Senyeah/12v-to-usb-c-data-splitter/docs/swift-usbc-3a-iso-back.png

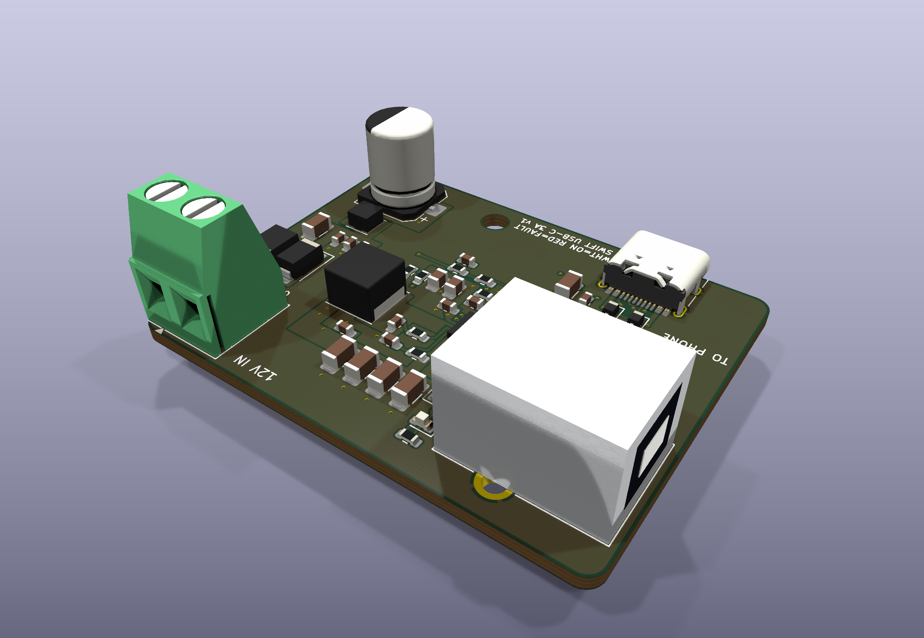
docs/swift-usbc-3a-iso-back.png
