Senyeah/12v-to-usb-c-data-splitter/docs/swift-usbc-3a-iso.png

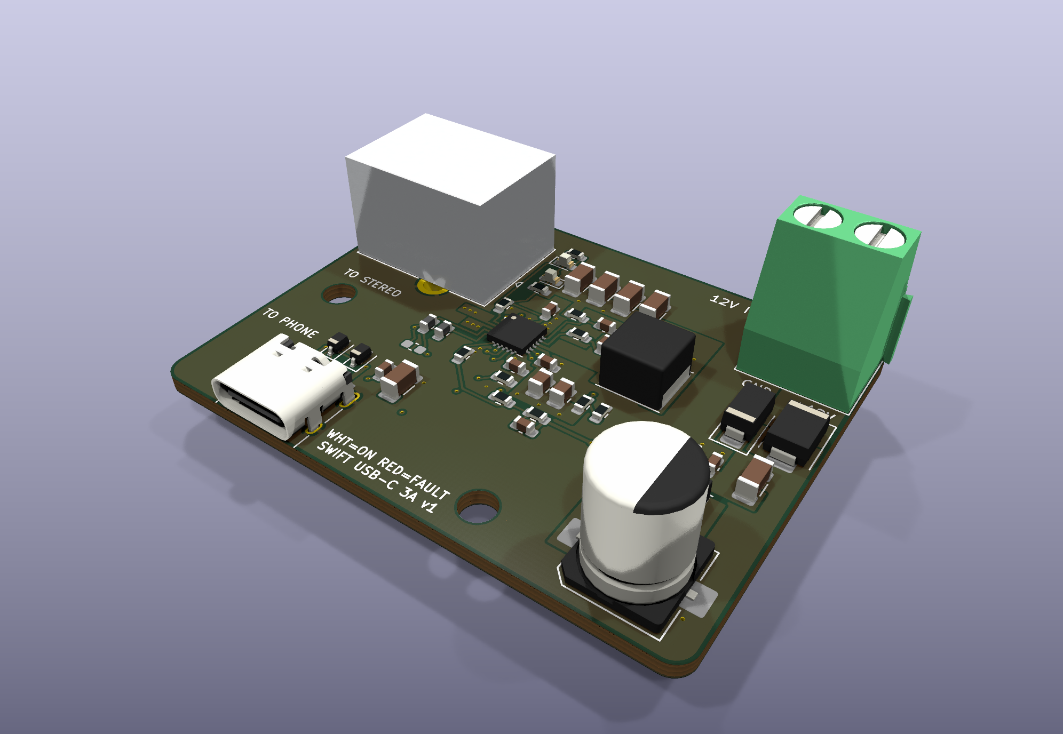
docs/swift-usbc-3a-iso.png
