Senyeah/12v-to-usb-c-data-splitter/docs/swift-usbc-3a-top.png

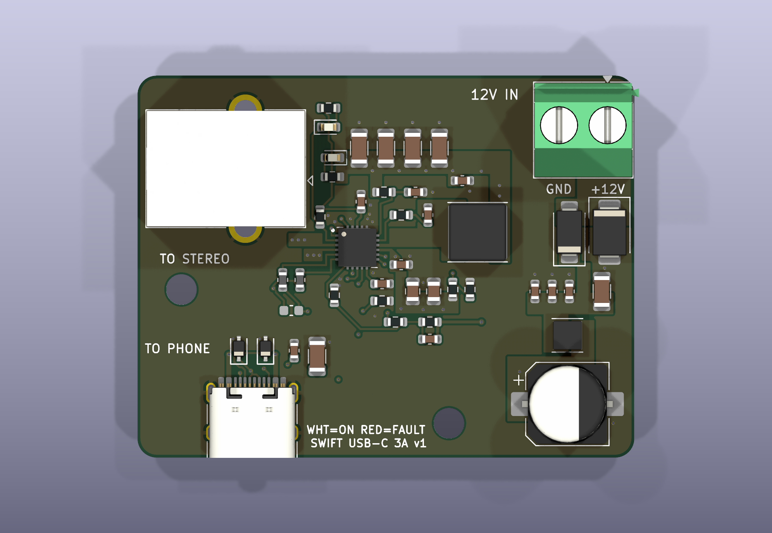
docs/swift-usbc-3a-top.png
