Senyeah/12v-to-usb-c-data-splitter/sim/zout.png

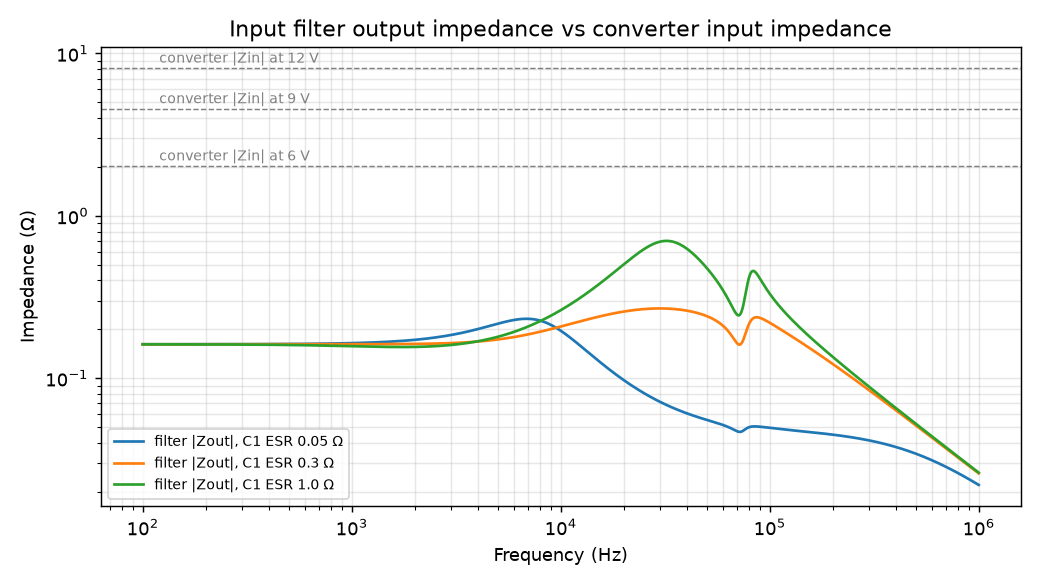
sim/zout.png
