Senyeah/12v-to-usb-c-data-splitter/fab/assembly/swift-usbc-3a-bom-jlc.csv

Comment | Designator | Footprint | LCSC Part #
100uF 50V | C1 | CP_Elec_8x10.5 | C19184158
4.7uF 50V | C2,C3 | C_0805_2012Metric | C20416422
100nF 50V | C4,C13,C20 | C_0603_1608Metric | C14663
1uF | C5 | C_0603_1608Metric | C15849
4.7uF | C6 | C_0603_1608Metric | C19666
220nF | C7,C25 | C_0603_1608Metric | C21120
22nF 50V | C11,C12 | C_0603_1608Metric | C21122
10uF 50V | C14,C27 | C_1206_3216Metric | C13585
22uF 25V | C21,C22,C23,C24 | C_1206_3216Metric | C12891
47pF C0G | C26 | C_0603_1608Metric | C1671
2.2nF | C28 | C_0603_1608Metric | C1604
SMBJ33CA | D1 | D_SMB | C19077587
SS510 | D2 | D_SMA | C18199171
PESD5V0U1UA | D3,D4 | D_SOD-323 | C19829579
White LED | D5 | LED_0603_1608Metric | C2290
FAULT red | D6 | LED_0603_1608Metric | C2286
USB-C to phone | J3 | USB_C_Receptacle_HRO_TYPE-C-31-M-12 | C165948
4.7uH 3.6A | L1 | L_APV_ANR6045 | C6808109
2.2uH 4.7A | L2 | L_Changjiang_FTC303020D | C7423318
0R | L3,L4,R9 | L_0603_1608Metric | C21189
100k | R1 | R_0603_1608Metric | C25803
36k 1% | R2 | R_0603_1608Metric | C23147
10k | R3 | R_0603_1608Metric | C25804
4.7R | R4 | R_0603_1608Metric | C23164
10R | R5 | R_0603_1608Metric | C22859
20k | R6 | R_0603_1608Metric | C4184
30k 1% | R7 | R_0603_1608Metric | C22984
5.6k 1% | R8 | R_0603_1608Metric | C23189
1k | R10,R11 | R_0603_1608Metric | C21190
MPQ4228GRE-C-AEC1 | U1 | MPS_QFN-22_4x4mm_P0.5mm | C17638787
