Senyeah/12v-to-usb-c-data-splitter/fab/docs/swift-usbc-3a-assembly.pdf

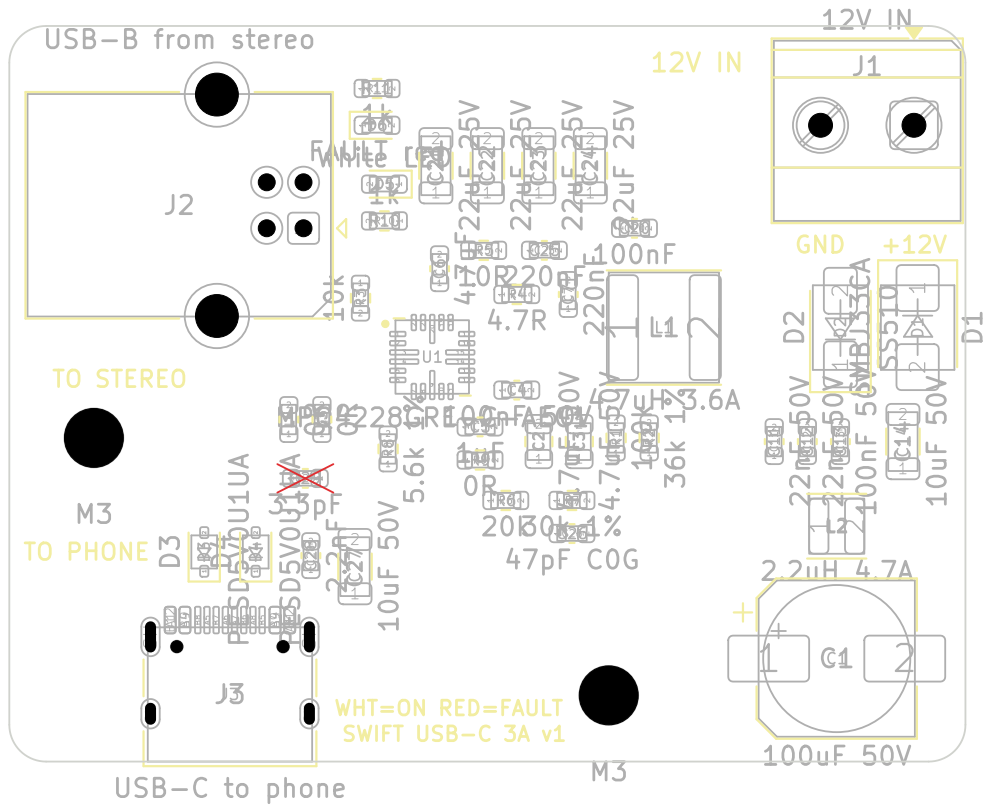
[picture p8: page 1]

2 WHT=ON RED=FAULT SWIFT USB-C 3A v1

Size: A4 | Rev:
KiCad E.D.A. 10.0.6 | Id: 1/1
