Senyeah/12v-to-usb-c-data-splitter/fab/docs/swift-usbc-3a-schematic.pdf

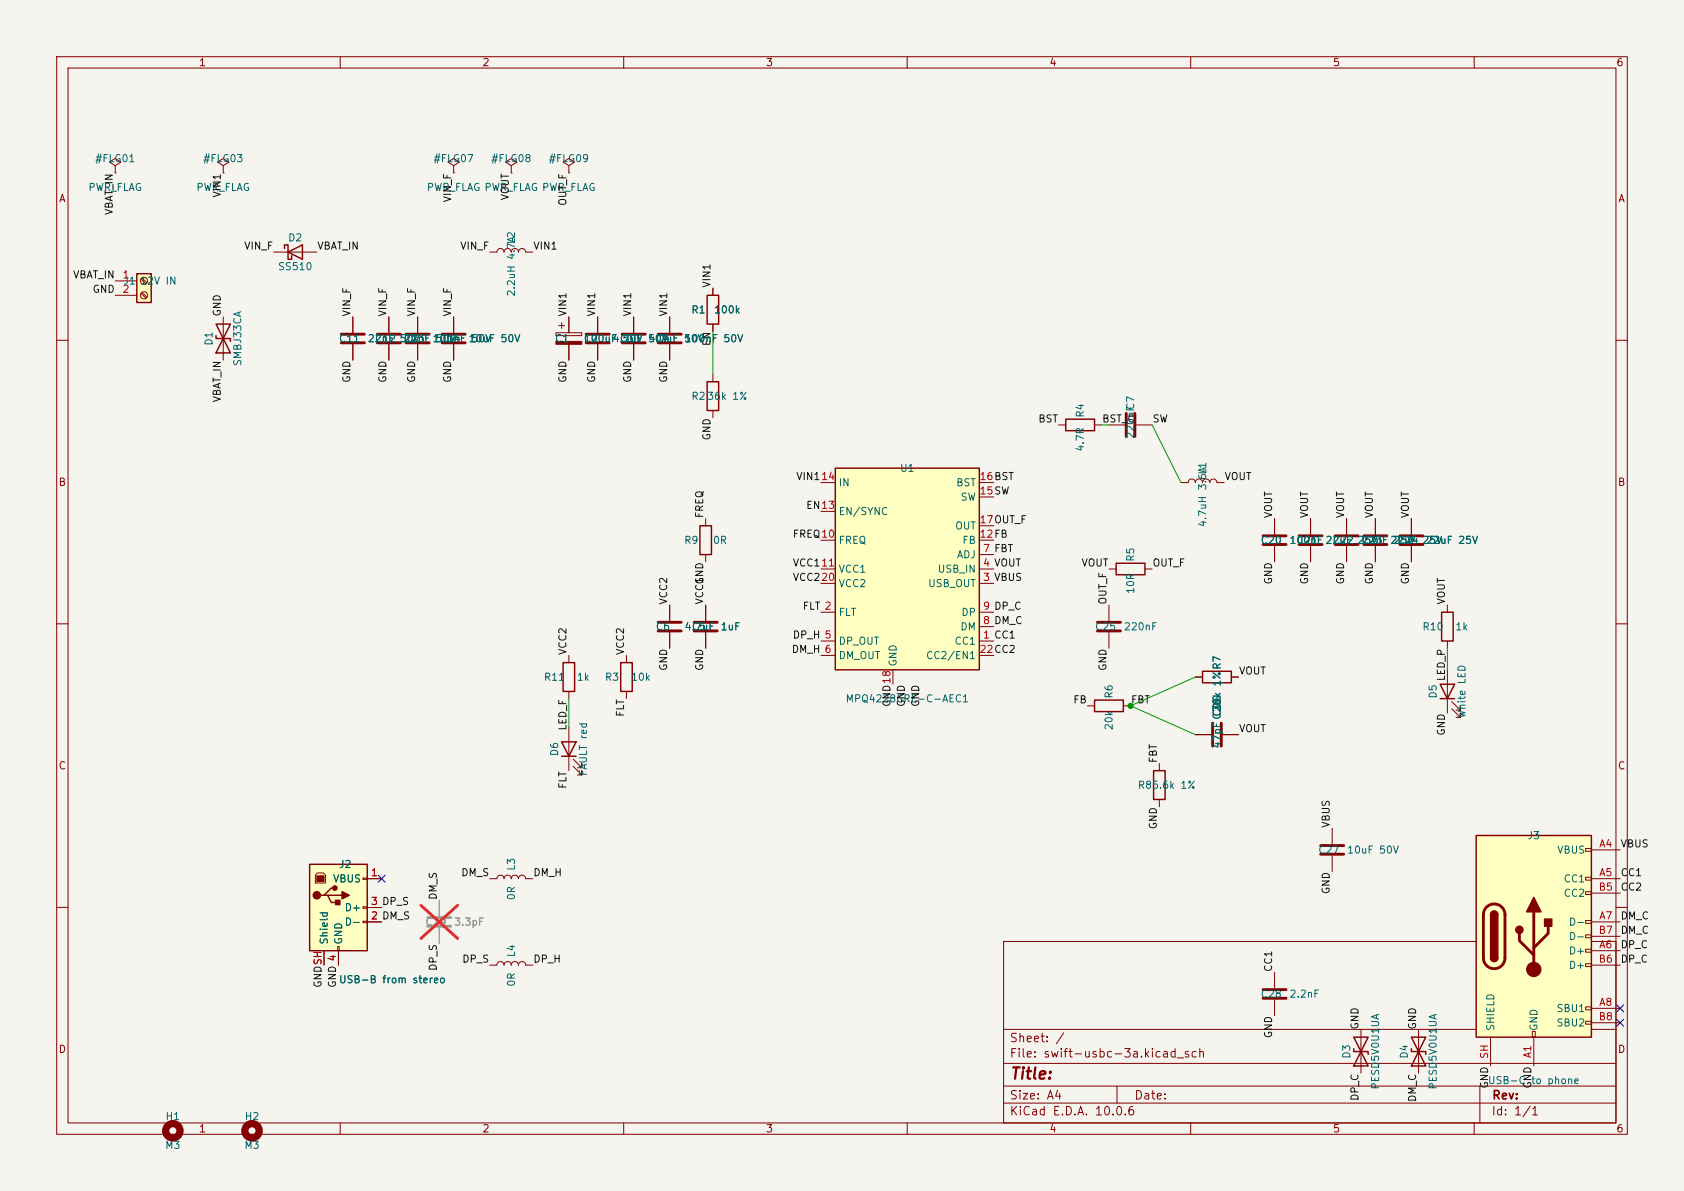
[picture p9: page 1]

SW 15 BST 16 OUT 17 GND 18

Size: A4 | Rev:
KiCad E.D.A. 10.0.6 | Id: 1/1
