Senyeah/12v-to-usb-c-data-splitter/fab/docs/swift-usbc-3a-layers.pdf

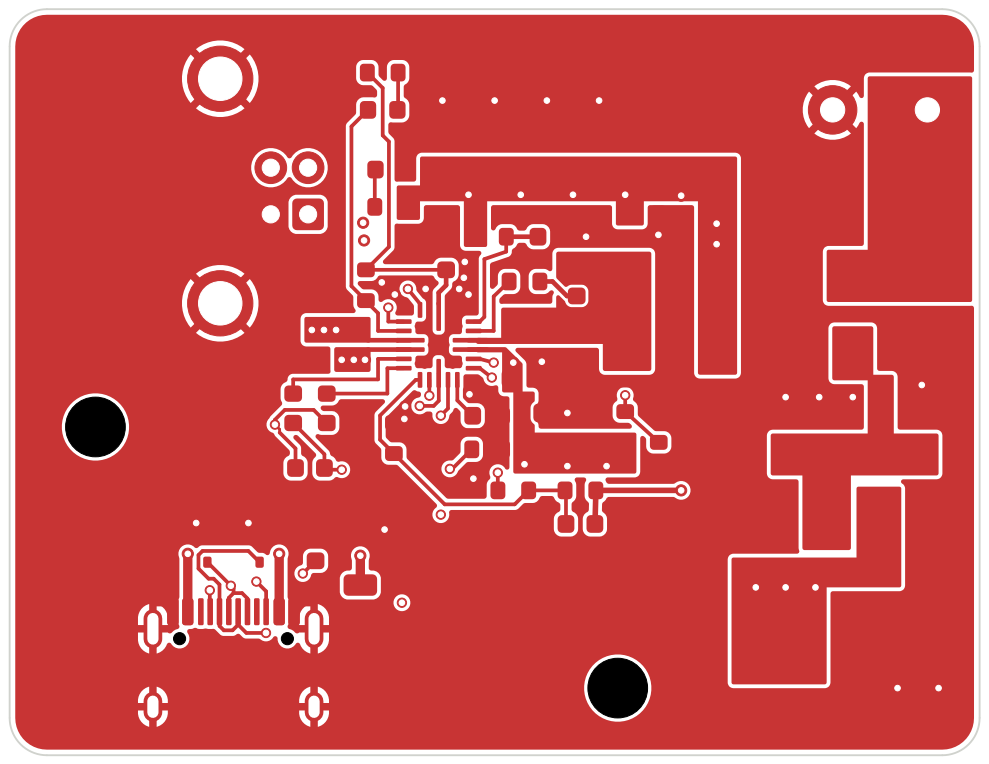
[picture p10: page 1]

Size: A4 | Rev:
KiCad E.D.A. 10.0.6 | Id: 1/5

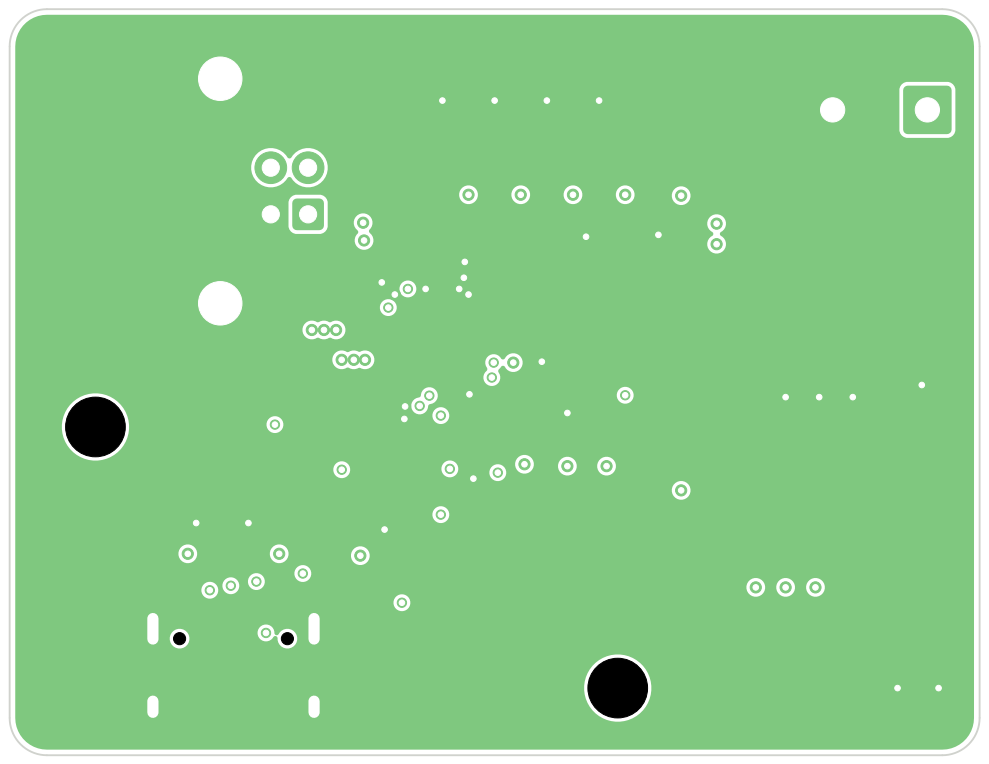
[picture p11: page 2]

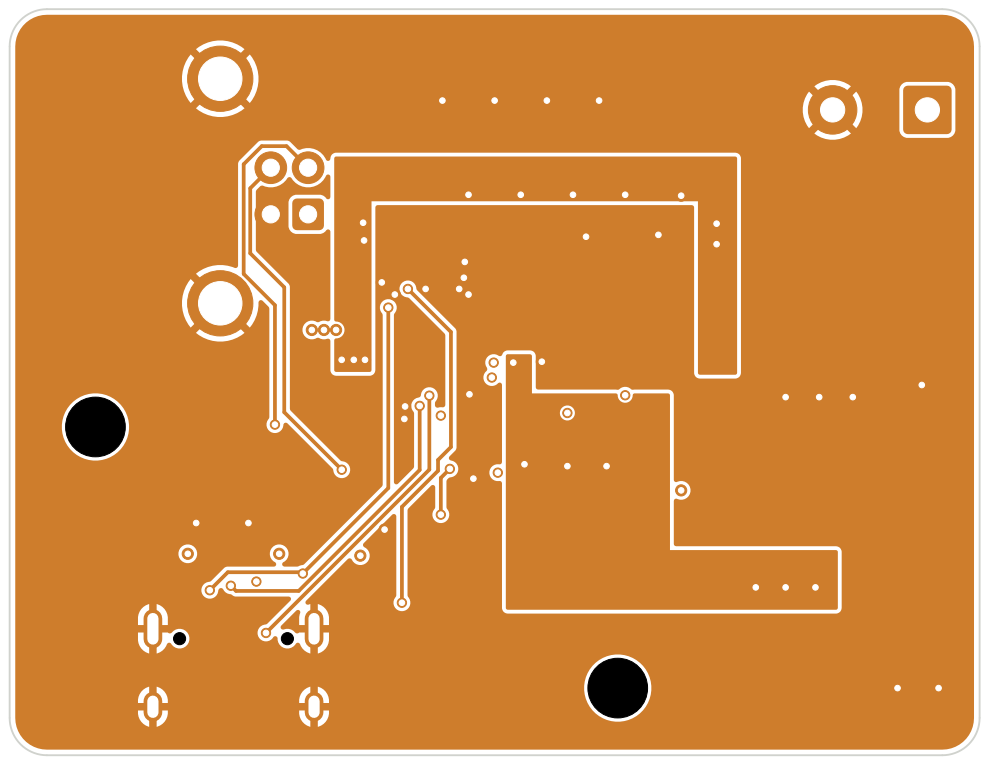
[picture p12: page 3]

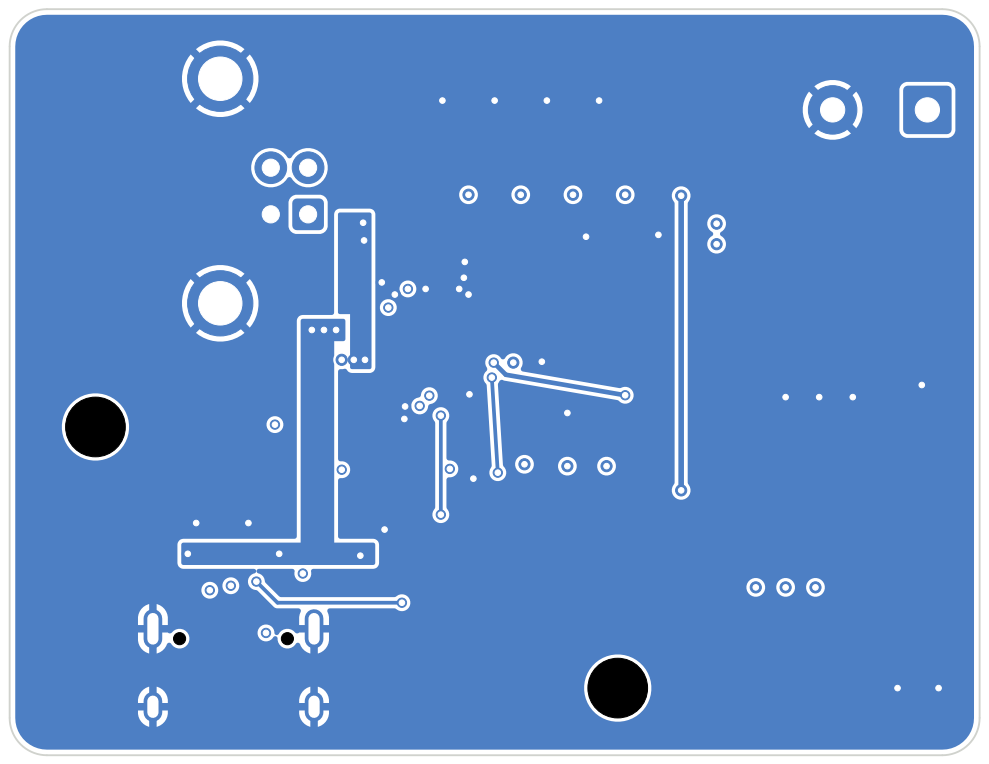
[picture p13: page 4]

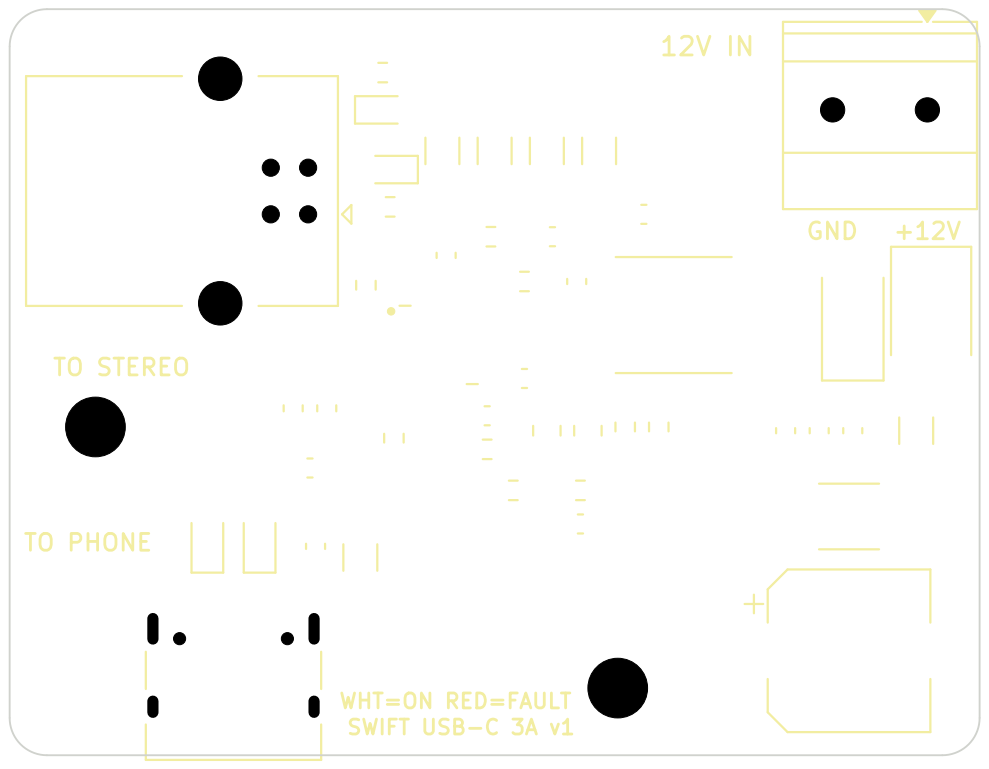
[picture p14: page 5]

WHT=ON RED=FAULT SWIFT USB-C 3A v1
