Senyeah/12v-to-usb-c-data-splitter/swift-usbc-3a.kicad_pcb

## KiCad design swift-usbc-3a.kicad_pcb (2026-10-21)

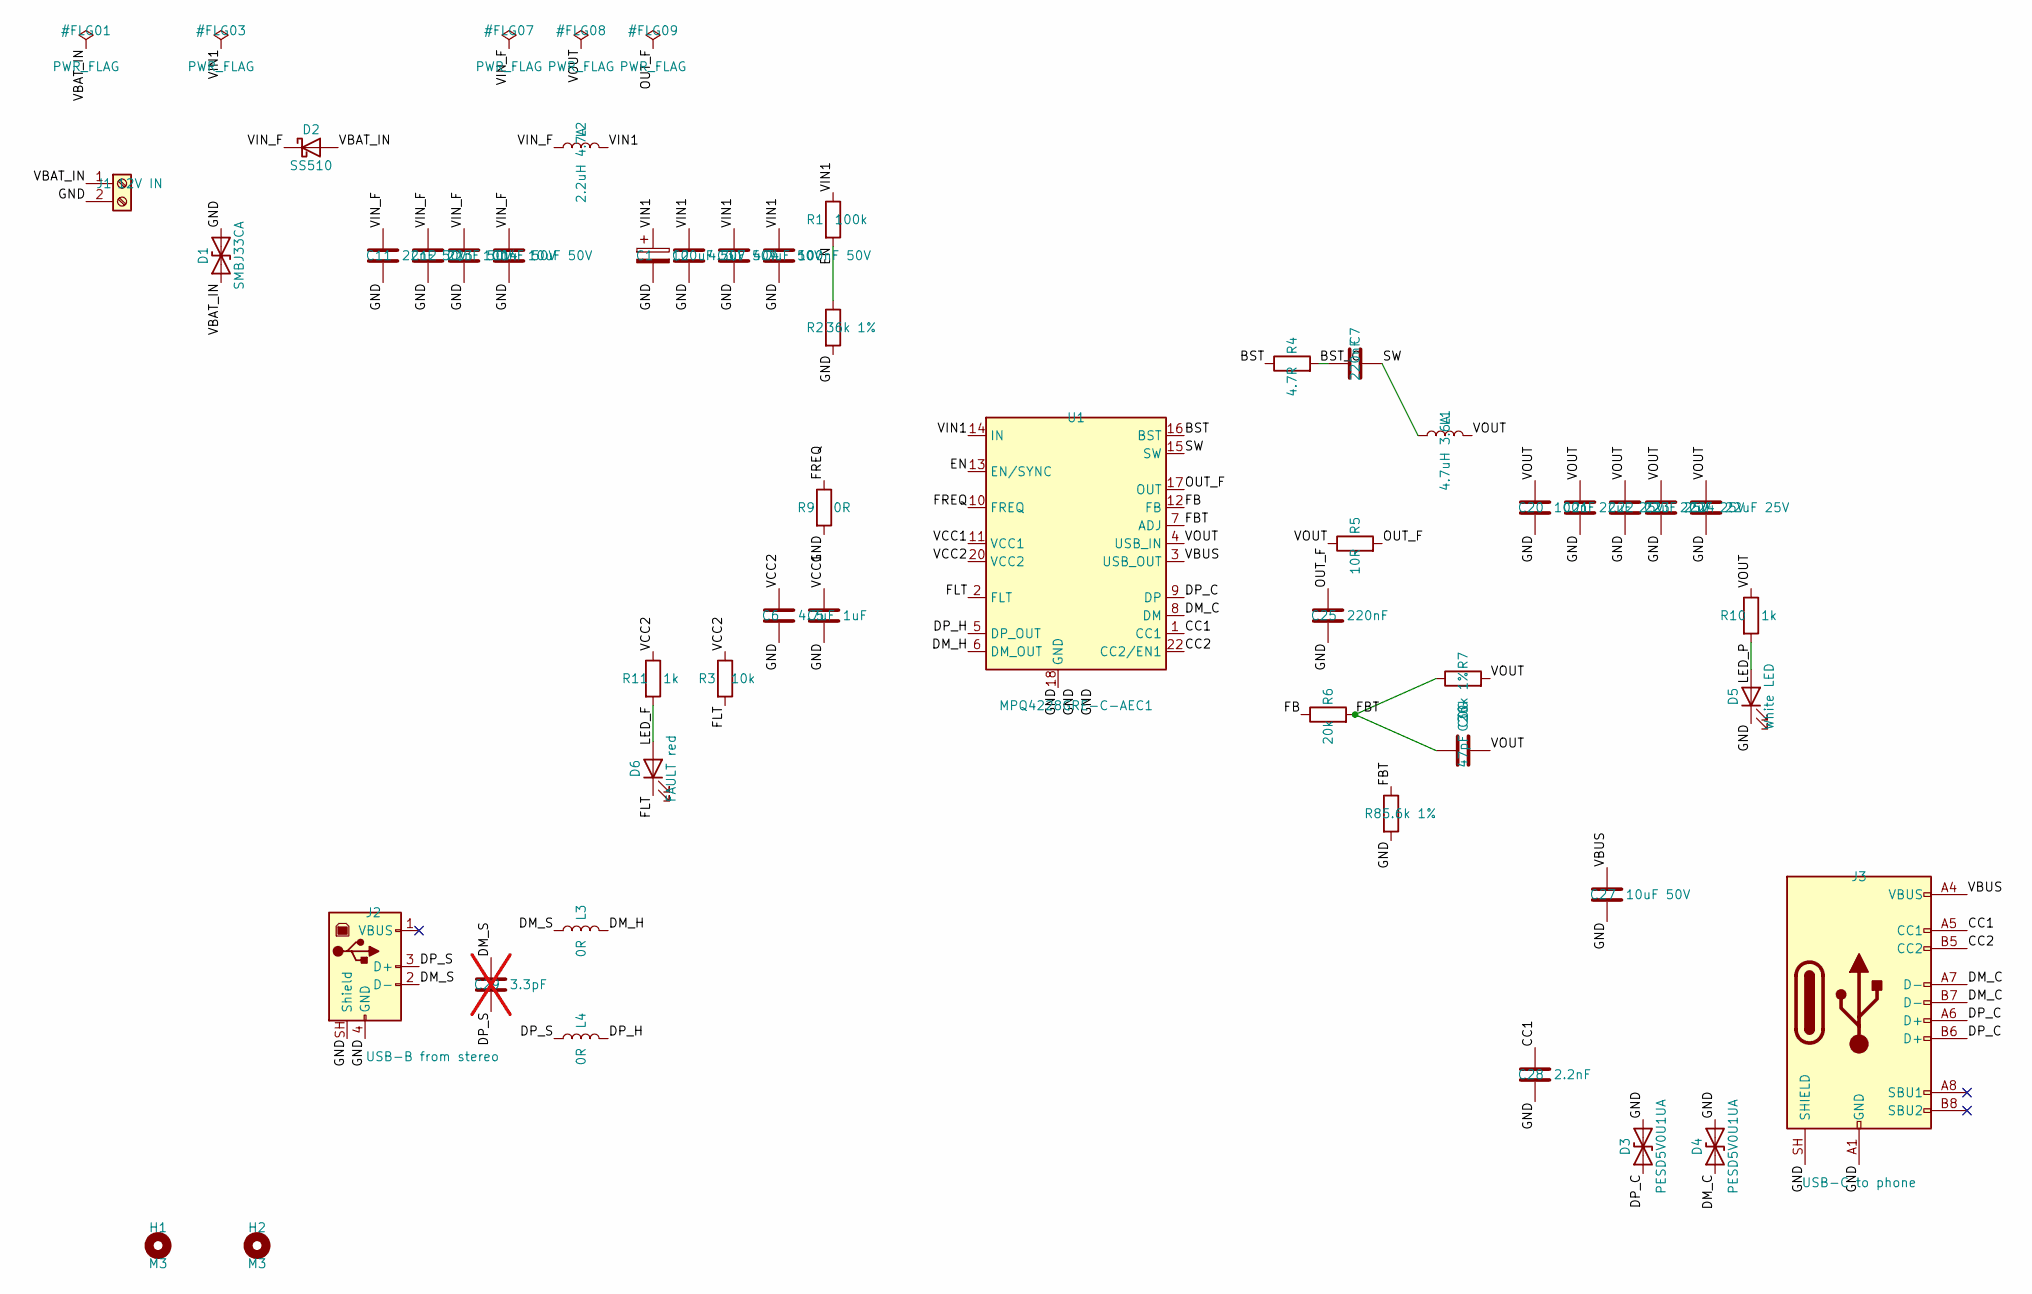
[picture p15: schematic swift-usbc-3a.kicad_sch]

Parts:
C1: 100uF 50V; CP_Elec_8x10.5; LCSC C19184158
C2, C3: 4.7uF 50V; C_0805_2012Metric; LCSC C20416422
C4, C13: 100nF 50V; C_0603_1608Metric; LCSC C14663
C5: 1uF; C_0603_1608Metric; LCSC C15849
C6: 4.7uF; C_0603_1608Metric; LCSC C19666
C7, C25: 220nF; C_0603_1608Metric; LCSC C21120
C11, C12: 22nF 50V; C_0603_1608Metric; LCSC C21122
C14, C27: 10uF 50V; C_1206_3216Metric; LCSC C13585
C20: 100nF; C_0603_1608Metric; LCSC C14663
C21, C22, C23, C24: 22uF 25V; C_1206_3216Metric; LCSC C12891
C26: 47pF C0G; C_0603_1608Metric; LCSC C1671
C28: 2.2nF; C_0603_1608Metric; LCSC C1604
C29: 3.3pF; C_0603_1608Metric; LCSC C7227538; not fitted
D1: SMBJ33CA; D_SMB; LCSC C19077587
D2: SS510; D_SMA; LCSC C18199171
D3, D4: PESD5V0U1UA; D_SOD-323; LCSC C19829579
D5: White LED; LED_0603_1608Metric; LCSC C2290
D6: FAULT red; LED_0603_1608Metric; LCSC C2286
H1, H2: M3; MountingHole_3.2mm_M3
J1: 12V IN; TerminalBlock_Phoenix_MKDS-1,5-2-5.08_1x02_P5.08mm_Horizont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; LCSC C7509570
J2: USB-B from stereo; USB_B_OST_USB-B1HSxx_Horizontal; LCSC C19944605
J3: USB-C to phone; USB_C_Receptacle_HRO_TYPE-C-31-M-12; LCSC C165948
L1: 4.7uH 3.6A; L_APV_ANR6045; LCSC C6808109
L2: 2.2uH 4.7A; L_Changjiang_FTC303020D; LCSC C7423318
L3, L4: 0R; L_0603_1608Metric; LCSC C21189
R1: 100k; R_0603_1608Metric; LCSC C25803
R2: 36k 1%; R_0603_1608Metric; LCSC C23147
R3: 10k; R_0603_1608Metric; LCSC C25804
R4: 4.7R; R_0603_1608Metric; MPN 0603WAF470KT5E; LCSC C23164
R5: 10R; R_0603_1608Metric; LCSC C22859
R6: 20k; R_0603_1608Metric; LCSC C4184
R7: 30k 1%; R_0603_1608Metric; LCSC C22984
R8: 5.6k 1%; R_0603_1608Metric; LCSC C23189
R9: 0R; R_0603_1608Metric; LCSC C21189
R10, R11: 1k; R_0603_1608Metric; LCSC C21190
U1: MPQ4228GRE-C-AEC1; MPS_QFN-22_4x4mm_P0.5mm; MPN MPQ4228GRE-C-AEC1-Z; LCSC C17638787

Connections:
/BST: R4.1, U1.16 (BST)
/BST_C: C7.1, R4.2
/CC1: C28.1, J3.A5 (CC1), U1.1 (CC1)
/CC2: J3.B5 (CC2), U1.22 (CC2/EN1)
/DM_C: D4.1 (A1), J3.A7 (D-), J3.B7 (D-), U1.8 (DM)
/DM_H: L3.2, U1.6 (DM_OUT)
/DM_S: C29.1, J2.2 (D-), L3.1
/DP_C: D3.1 (A1), J3.A6 (D+), J3.B6 (D+), U1.9 (DP)
/DP_H: L4.2, U1.5 (DP_OUT)
/DP_S: C29.2, J2.3 (D+), L4.1
/EN: R1.2, R2.1, U1.13 (EN/SYNC)
/FB: R6.1, U1.12 (FB)
/FBT: C26.1, R6.2, R7.1, R8.1, U1.7 (ADJ)
/FLT: D6.1 (K), R3.2, U1.2 (FLT)
/FREQ: R9.1, U1.10 (FREQ)
/GND: C1.2, C2.2, C3.2, C4.2, C5.2, C6.2, C11.2, C12.2, C13.2, C14.2, C20.2, C21.2, C22.2, C23.2, C24.2, C25.2, C27.2, C28.2, D1.2 (A2), D3.2 (A2), D4.2 (A2), D5.1 (K), J1.2, J2.4 (GND), J2.SH (Shield), J3.A1 (GND), J3.A12 (GND), J3.B1 (GND), J3.B12 (GND), J3.SH (SHIELD), R2.2, R8.2, R9.2, U1.18 (GND), U1.19 (GND), U1.21 (GND)
/LED_F: D6.2 (A), R11.2
/LED_P: D5.2 (A), R10.2
/OUT_F: C25.1, R5.2, U1.17 (OUT)
/SW: C7.2, L1.1, U1.15 (SW)
/VBAT_IN: D1.1 (A1), D2.2 (A), J1.1
/VBUS: C27.1, J3.A4 (VBUS), J3.A9 (VBUS), J3.B4 (VBUS), J3.B9 (VBUS), U1.3 (USB_OUT)
/VCC1: C5.1, U1.11 (VCC1)
/VCC2: C6.1, R3.1, R11.1, U1.20 (VCC2)
/VIN1: C1.1, C2.1, C3.1, C4.1, L2.2, R1.1, U1.14 (IN)
/VIN_F: C11.1, C12.1, C13.1, C14.1, D2.1 (K), L2.1
/VOUT: C20.1, C21.1, C22.1, C23.1, C24.1, C26.2, L1.2, R5.1, R7.2, R10.1, U1.4 (USB_IN)

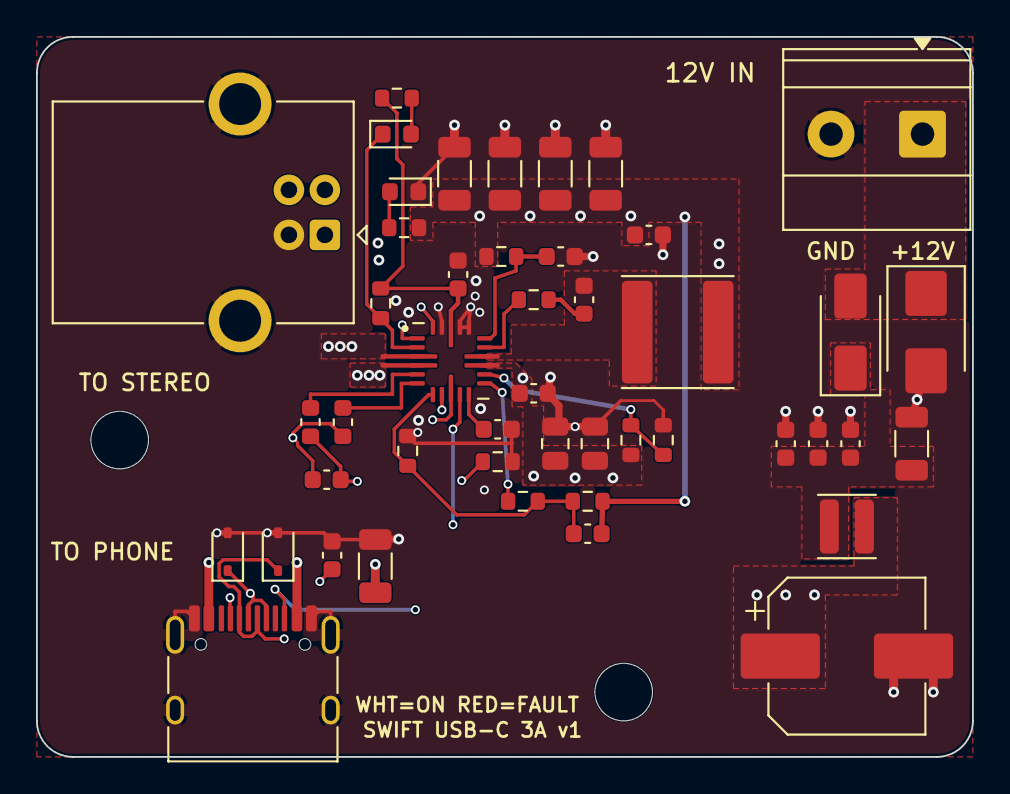
[picture p16: board swift-usbc-3a.kicad_pcb from above]

Board: 4 copper layers, 52.0 x 40.0 mm, 48 parts (0 on the bottom side), 27 nets.
